SOEKOEK/LoRa-telemetry-station/poster loraboei flattened.jpg

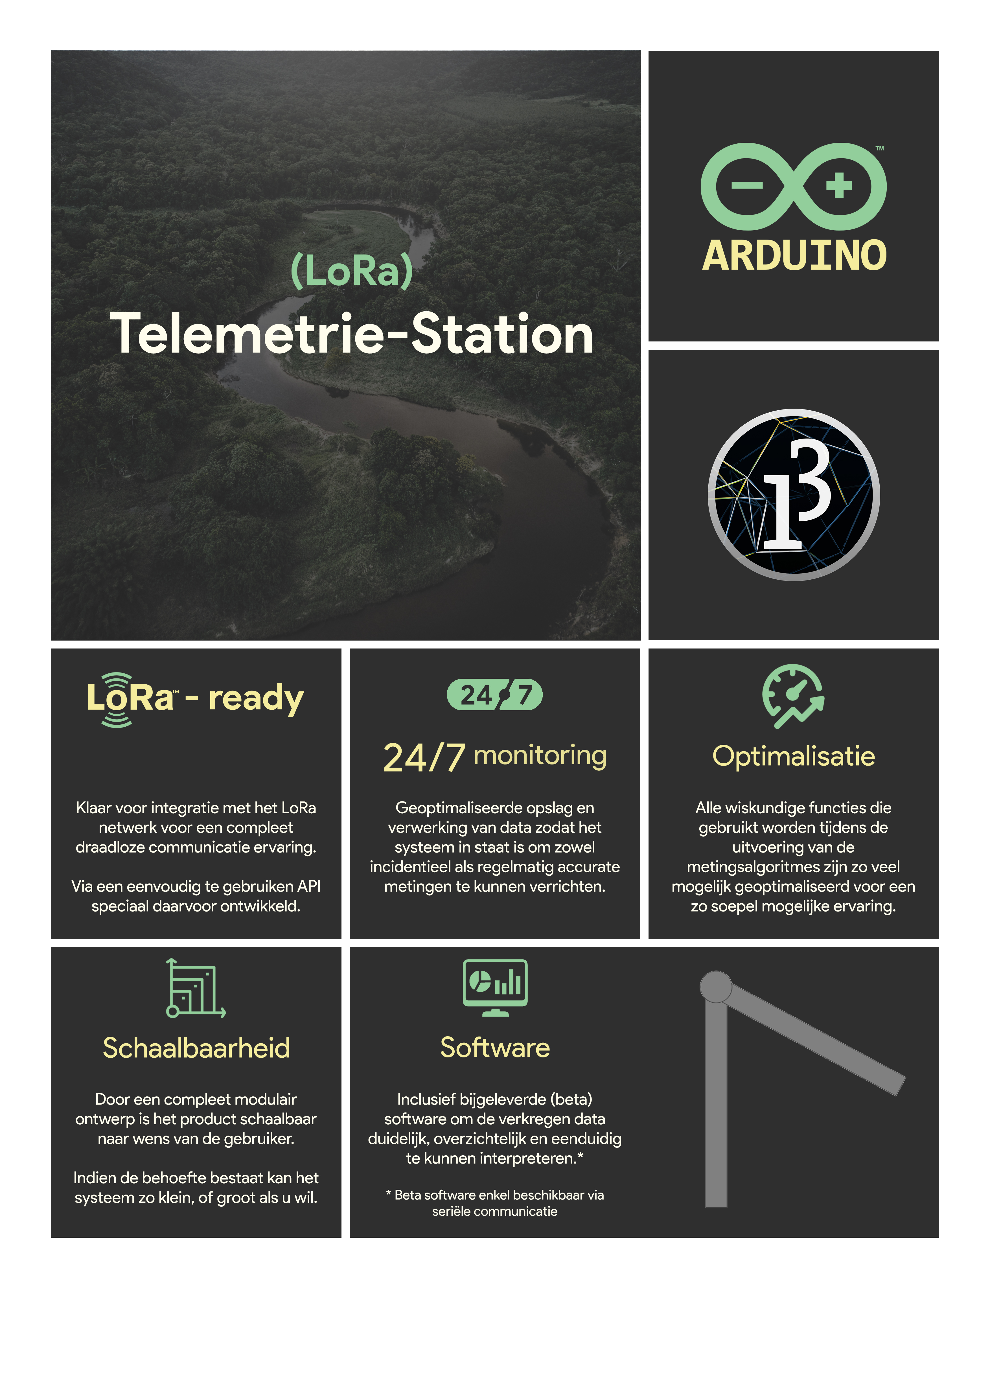
poster loraboei flattened.jpg
