SOEKOEK/LoRa-telemetry-station/(list of files, drawings)

Other design files:
Telemetrie station fritzing.fzz
